loopea-lab/weird-audio-hat-hw/3dModels/CUI_DEVICES_MJ-3536N/BOM.txt

3DX_CUI_DEVICES_Supplier: CUI Devices
3DX_CUI_DEVICES_Description: 3.5 mm, Mono, Right Angle, Through Hole, 2 Conductors, 1 Internal Switch, Audio Jack Connector
3DX_CUI_DEVICES_Model Number: MJ-3536N
