loopea-lab/weird-audio-hat-hw/3dModels/CUI_DEVICES_MJ-3536N/CUI_DEVICES_MJ-3536N.step

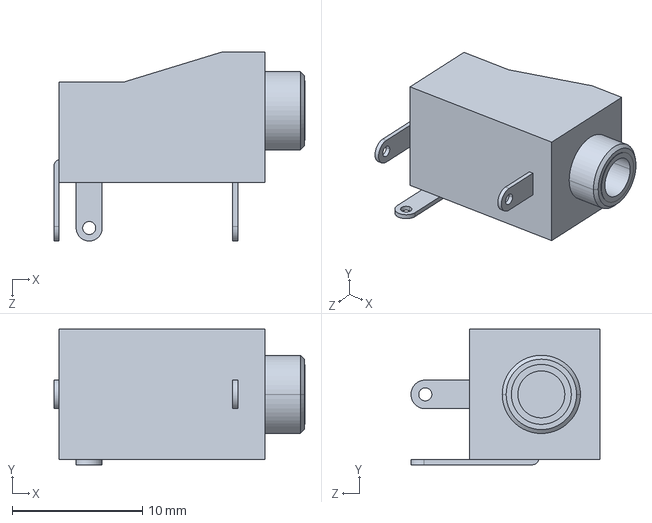
[picture p1: CAD file, 2024-04-04]
3dModels/CUI_DEVICES_MJ-3536N/CUI_DEVICES_MJ-3536N.step
19.2 x 10.4 x 14.5 mm
