loopea-lab/weird-audio-hat-hw/(list of files, cad)

Other CAD files:
3dModels/CUI_DEVICES_MJ-3536N/CUI_DEVICES_MJ-3536N.STL
