loopea-lab/weird-audio-hat-hw/WM_RB-HAT_schematic.pdf

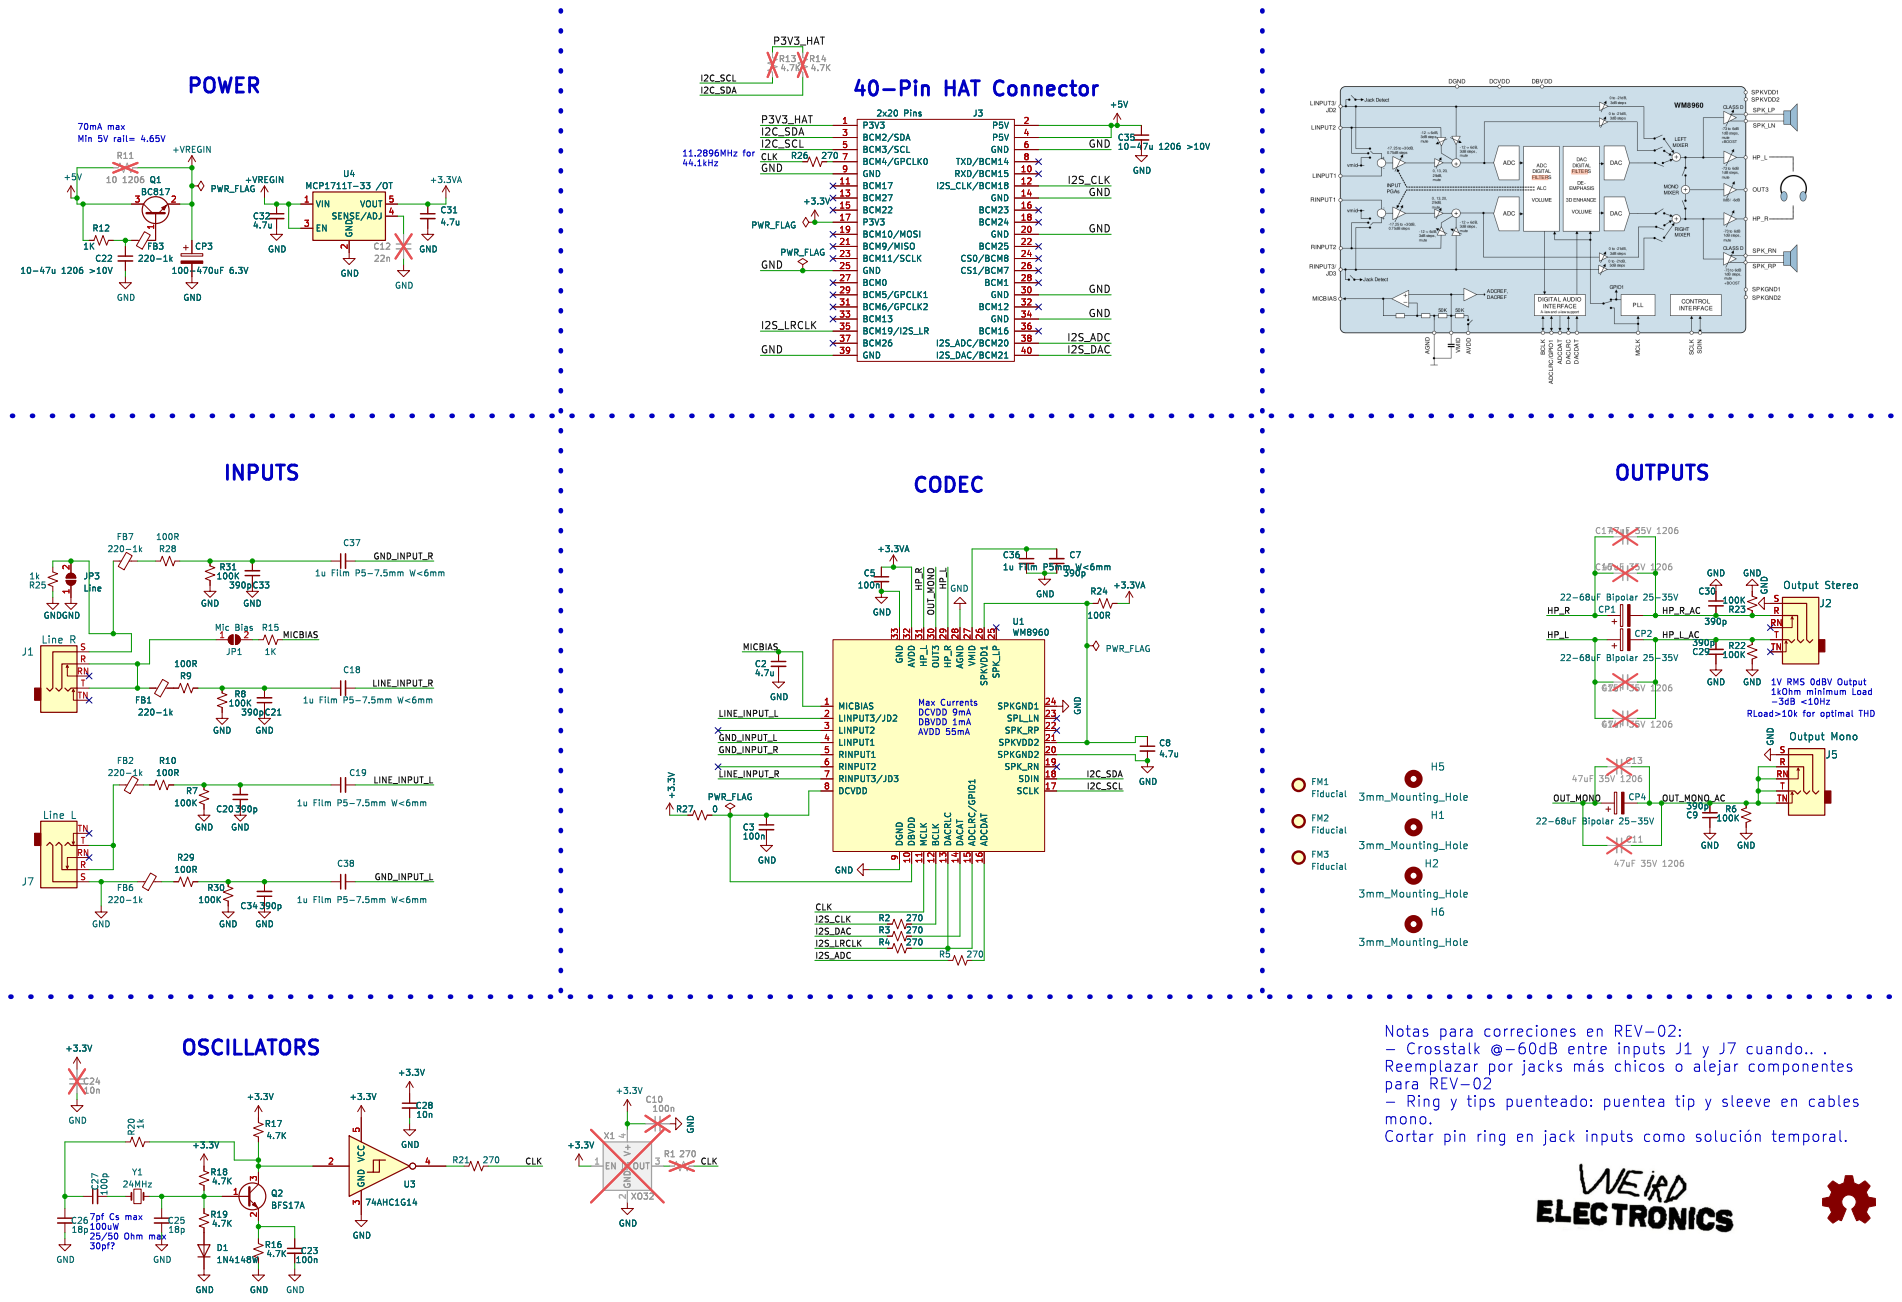
[picture p2: page 1]

2 EN 3 SENSE/ADJ 4 VOUT 5 U4 MCP1711T-33 /OT R9

2 EN 3 SENSE/ADJ 4 VOUT 5 GND

Max Currents DCVDD 9mA DBVDD 1mA

para REV-02
mono.
Cortar pin ring en jack inputs como þÿsolución temporal.
