loopea-lab/weird-audio-hat-hw/WM_RB-HAT.kicad_pcb

## KiCad design WM_RB-HAT.kicad_pcb (2024-04-20)

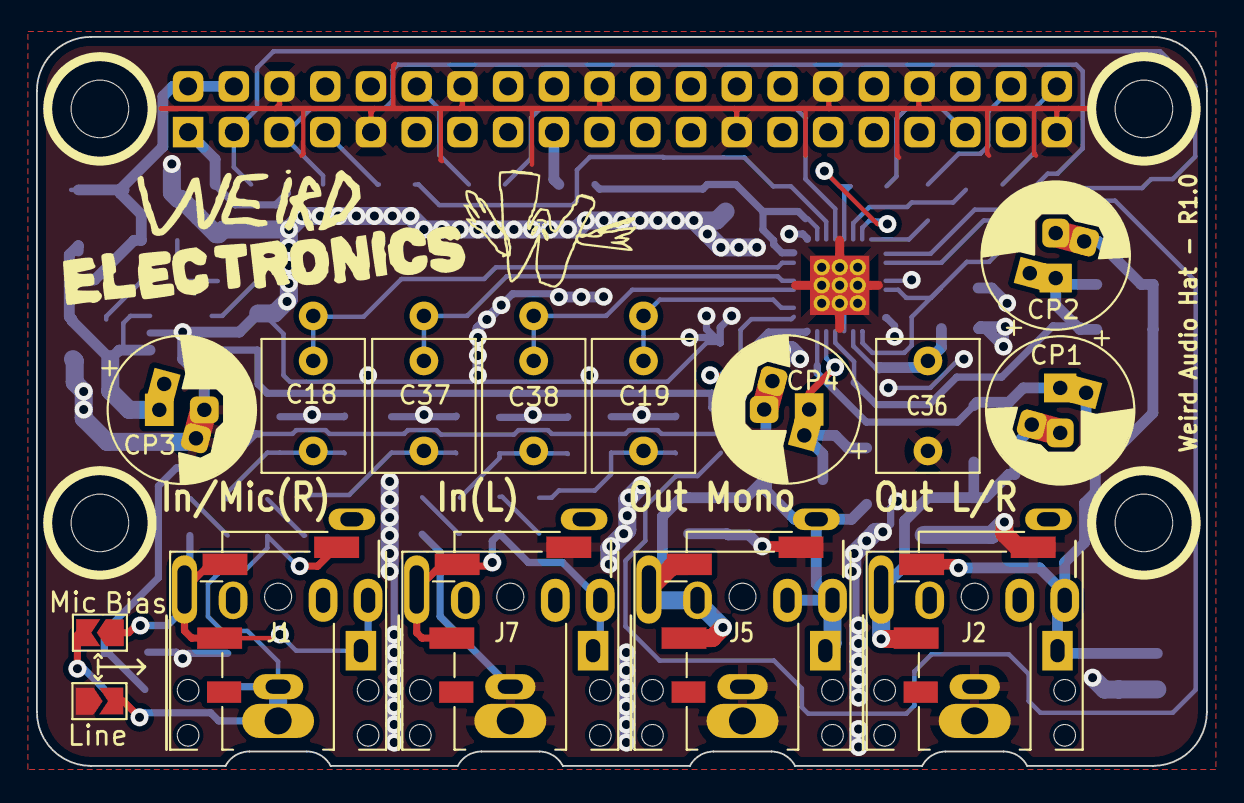
[picture p3: board WM_RB-HAT.kicad_pcb from above]

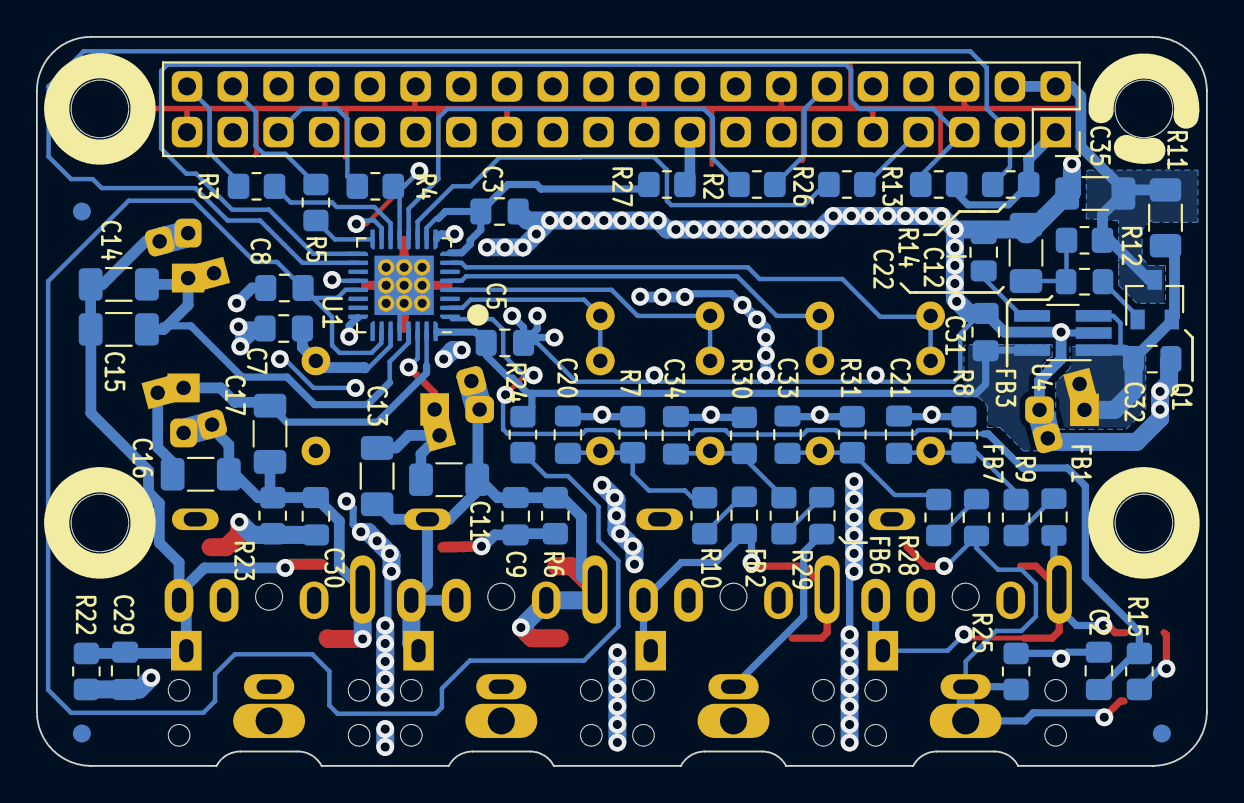
[picture p4: board WM_RB-HAT.kicad_pcb from below]

Board: 2 copper layers, 65.0 x 40.5 mm, 78 parts (59 on the bottom side), 47 nets.

Parts:
C2, C7, C8, C31, C32: 4.7u; C_0805_2012Metric_Pad1.18x1.45mm_HandSolder
C3, C5: 100n; C_0805_2012Metric_Pad1.18x1.45mm_HandSolder
C9, C20, C21, C29, C30, C33, C34: pf; C_0805_2012Metric_Pad1.18x1.45mm_HandSolder
C11, C13, C14, C15, C16, C17: 47uF 35V 1206; C_1206_3216Metric_Pad1.33x1.80mm_HandSolder
C12: 22n; C_0805_2012Metric_Pad1.18x1.45mm_HandSolder
C18, C19, C37, C38: 1u Film P5-7.5mm W<6mm; C_Rect_Film_L7.2mm_W5.5mm_P5.00mm_7.5mm_Combo_FKS2_FKP2_MKS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
C22, C35: 10-47u 1206 >10V; C_1206_3216Metric_Pad1.33x1.80mm_HandSolder
C36: 1u Film P5mm W<6mm; C_Rect_L7.2mm_W5.5mm_P5.00mm_FKS2_FKP2_MKS2_MKP2
CP1, CP2, CP4: 22-68uF Bipolar 25-35V; CP_Radial_D8.0mm_P2.50-3.5mm_100uF_Mejores_Pads
CP3: 100-470uF 6.3V; CP_Radial_D8.0mm_P2.50-3.5mm_100uF_Mejores_Pads
FB1, FB2, FB3, FB6, FB7: 220-1k; L_0805_2012Metric_Pad1.15x1.40mm_HandSolder
FM1, FM2, FM3: Fiducial; Fiducial_1mm_Mask2mm
H1, H2, H5, H6: 3mm_Mounting_Hole; MountingHole_3.2mm_M3_Keepout
J1: Line R; Jack_3.5mm_Combo_CUI_SJ1-3525N_Horizontal
J2: Output Stereo; Jack_3.5mm_Combo_CUI_SJ1-3525N_Horizontal
J3: 2x20 Pins; PinSocket_2x20_P2.54mm_Vertical
J5: Output Mono; Jack_3.5mm_Combo_CUI_SJ1-3525N_Horizontal
J7: Line L; Jack_3.5mm_Combo_CUI_SJ1-3525N_Horizontal
JP1: Mic Bias; SolderJumper-2_P1.3mm_Open_TrianglePad1.0x1.5mm
JP3: Line; SolderJumper-2_P1.3mm_Open_TrianglePad1.0x1.5mm
Q1: BC817; SOT-23_Mefores_Pads
R2, R3, R4, R5, R26: 10R; R_0805_2012Metric_Pad1.20x1.40mm_HandSolder
R6, R22, R23: 10K; R_0805_2012Metric_Pad1.20x1.40mm_HandSolder
R7, R8, R30, R31: 100K; R_0805_2012Metric_Pad1.20x1.40mm_HandSolder
R9, R10, R28, R29: 100R; R_0805_2012Metric_Pad1.20x1.40mm_HandSolder
R11: 10 1206; R_1206_3216Metric_Pad1.30x1.75mm_HandSolder
R12, R15, R24: 1K; R_0805_2012Metric_Pad1.20x1.40mm_HandSolder
R13, R14: 4.7K; R_0805_2012Metric_Pad1.20x1.40mm_HandSolder
R25: 1k; R_0805_2012Metric_Pad1.20x1.40mm_HandSolder
R27: 0; R_0805_2012Metric_Pad1.20x1.40mm_HandSolder
U1: WM8960; QFN-32-1EP_5x5mm_P0.5mm_EP3.3x3.3mm_Handsolder
U4: MCP1711T-33 /OT; TSOT-23-5_HandSoldering

Connections:
+3.3V: J3.17 (P3V3), R27.2
+3.3VA: C5.1, C31.1, R24.1, U1.32 (AVDD), U4.5 (VOUT)
+5V: C35.1, J3.2 (P5V), J3.4 (P5V), Q1.3 (C), R11.2, R12.2
+VREGIN: C32.1, CP3.1, Q1.2 (E), R11.1, U4.1 (VIN), U4.3 (EN)
/CLK: R26.2, U1.11 (MCLK)
/GND_INPUT_L: C38.2, U1.4 (LINPUT1)
/GND_INPUT_R: C37.2, U1.5 (RINPUT1)
/HP_L: C14.1, C15.1, CP2.1, U1.29 (HP_R)
/HP_L_AC: C14.2, C15.2, C29.2, CP2.2, J2.T, R22.2
/HP_R: C16.1, C17.1, CP1.1, U1.31 (HP_L)
/HP_R_AC: C16.2, C17.2, C30.2, CP1.2, J2.R, R23.2
/I2C_SCL: J3.5 (BCM3/SCL), R13.1, U1.17 (SCLK)
/I2C_SDA: J3.3 (BCM2/SDA), R14.1, U1.18 (SDIN)
/I2S_ADC: J3.38 (I2S_ADC/BCM20), R5.2
/I2S_CLK: J3.12 (I2S_CLK/BCM18), R2.2
/I2S_DAC: J3.40 (I2S_DAC/BCM21), R3.2
/I2S_LRCLK: J3.35 (BCM19/I2S_LR), R4.2
/LINE_INPUT_L: C19.2, U1.2 (LINPUT3/JD2)
/LINE_INPUT_R: C18.2, U1.7 (RINPUT3/JD3)
/MICBIAS: C2.1, R15.2, U1.1 (MICBIAS)
/OUT_MONO: C11.2, C13.1, CP4.1, U1.30 (OUT3)
/OUT_MONO_AC: C9.2, C11.1, C13.2, CP4.2, J5.R, J5.RN, J5.T, J5.TN, R6.2
/P3V3_HAT: J3.1 (P3V3), R13.2, R14.2
GND: C2.2, C3.2, C5.2, C7.1, C8.2, C9.1, C12.2, C20.1, C21.1, C22.2, C29.1, C30.1, C31.2, C32.2, C33.1, C34.1, C35.2, C36.2, CP3.2, FB6.1, J2.S, J3.6 (GND), J3.9 (GND), J3.14 (GND), J3.20 (GND), J3.25 (GND), J3.30 (GND), J3.34 (GND), J3.39 (GND), J5.S, J7.S, JP3.1 (A), R6.1, R7.1, R8.1, R22.1, R23.1, R25.2, R30.1, R31.1, U1.9 (DGND), U1.20 (SPKGND2), U1.24 (SPKGND1), U1.28 (AGND), U1.33 (GND), U4.2 (GND)
unnamed: C18.1, C21.2, R8.2, R9.1
unnamed: C19.1, C20.2, R7.2, R10.1
unnamed: C22.1, FB3.1, R12.1
unnamed: C33.2, C37.1, R28.1, R31.2
unnamed: C34.2, C38.1, R29.1, R30.2
unnamed: FB1.2, R9.2
unnamed: FB2.1, J7.R, J7.T
unnamed: FB2.2, R10.2
unnamed: FB6.2, R29.2
unnamed: FB7.2, R28.2
unnamed: J3.7 (BCM4/GPCLK0), R26.1
unnamed: FB1.1, J1.R, J1.T, JP1.1 (A)
unnamed: JP1.2 (B), R15.1
unnamed: FB7.1, J1.S, JP3.2 (B), R25.1
unnamed: FB3.2, Q1.1 (B)
unnamed: R5.1, U1.16 (ADCDAT)
unnamed: R4.1, U1.13 (DACRLC), U1.15 (ADCLRC/GPIO1)
unnamed: R2.1, U1.12 (BCLK)
unnamed: R3.1, U1.14 (DACAT)
unnamed: C3.1, R27.1, U1.8 (DCVDD), U1.10 (DBVDD)
unnamed: C8.1, R24.2, U1.21 (SPKVDD2), U1.26 (SPKVDD1)
unnamed: C7.2, C36.1, U1.27 (VMID)
unnamed: C12.1, U4.4 (SENSE/ADJ)
