loopea-lab/weird-audio-hat-hw/(commit log)

2024-04-04 Initial commit: Open-sourcing the hardware design of the Weird Audio Hat
    [CUI_DEVICES_MJ-3536N.STL, CUI_DEVICES_MJ-3536N.step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]
2024-04-20 Added some notes for the next revision. General cleanup.
    [WM_RB-HAT-B_Cu.gbl, WM_RB-HAT-B_Mask.gbs, WM_RB-HAT-B_Silkscreen.gbo, WM_RB-HAT-Edge_Cuts.gm1, WM_RB-HAT-F_Cu.gtl, WM_RB-HAT-F_Mask.gts, WM_RB-HAT-F_Paste.gtp, WM_RB-HAT-F_Silkscreen.gto]
2024-10-10 Added PDF schematic
